ECE3400Team17/ECE3400_Team17/about_us.md

[To Home Page](./index.md)

# Get to Know Us

## Mira A. Bhut 
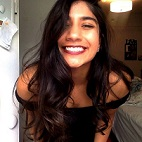
[picture p74: images/ourPics/mira.jpg]

### Contact: 
mab586@cornell.edu
### Background:
Hi, I'm Mira, a junior ECE. My interests in ECE are in electronics and embedded systems. At cornell I'm involved in Cornell Mars Rover, the fitness centers and recreational sports officiating, and tradition. I enjoy hiking and cycling and love pottery. I love reading about technology and would happily take any cool links to articles or videos you have!

## Yijia Chen 
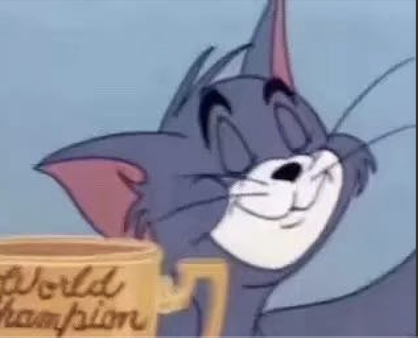
[picture p75: images/ourPics/yijia.jpg]

### Contact:
yc2366@cornell.edu
### Background:
I am a junior in ECE, from China.  I am interested in playing all kinds of instruments, taking a walk whenever I'm free, and reading whatever is interesting. I am Right now, making a robot with 4 brilliant buddies.

## Yirong Alan Cheng
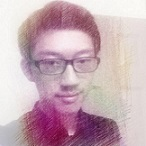
[picture p76: images/ourPics/alan.jpg]
 
### Contact:
yc2353@cornell.edu
### Background:
I am a junior in ECE. I just transferred here from UIUC in Illinois. I am the member of the IEEE-HKN (an ECE honor society). My main interests are signal processing and multimedia. I used to play badminton and swim, but now become much more indoor-orientated. I love reading books about philosophy and history on the free time, and I am also a member of the drama club.

## Thinesiya Krishnthasan

### Contact:
tk455@cornll.edu
### Background:
I'm a senior in ECE from New York City. I'm part of Cornell's Cube Satillite Team named OAAN (will be renamed VERONA soon). I enjoy working with radios, which is my independet research project here at Cornell. During my free time I love to draw, paint, and dance.

## Stephanie Lin
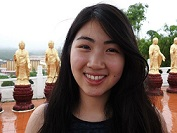
[picture p77: images/ourPics/stephanie.jpg]

### Contact:
scl97@cornell.edu
### Background:
A junior in ECE with a business minor. Hometown is the Windy City of Chicago. Likes to draw, learn languages, and drink bubble tea. Currently part of the Cornell Badminton Club with three State championship medals and will challenge anyone who dares, even a robot.

## Peter Slater
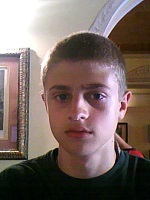
[picture p78: images/ourPics/peter.jpg]

### Contact:
pas324@cornell.edu
### Background:

[To Home Page](./index.md)
