ECE3400Team17/ECE3400_Team17/images/20170916_174542.jpg

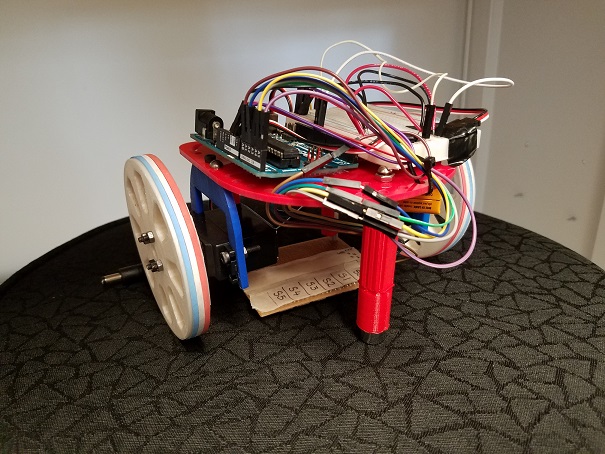
images/20170916_174542.jpg
