ECE3400Team17/ECE3400_Team17/images/frenchPolice.PNG

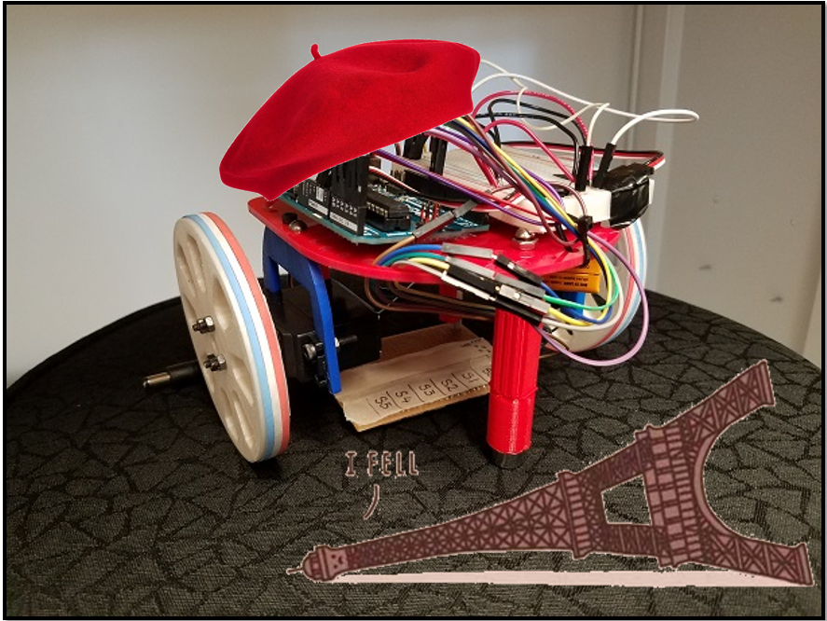
images/frenchPolice.PNG
