ECE3400Team17/ECE3400_Team17/images/Lab1/pot_LED.jpg

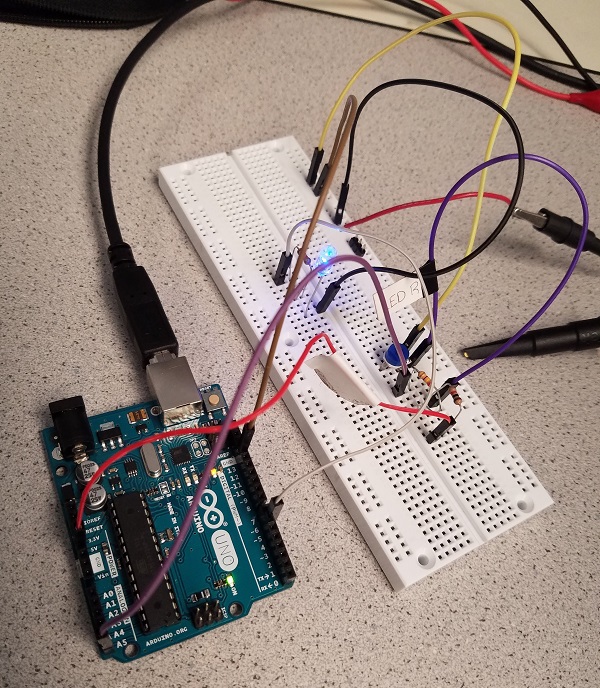
images/Lab1/pot_LED.jpg
