ECE3400Team17/ECE3400_Team17/images/Lab2/acoustics/highpass_amp_Plot.PNG

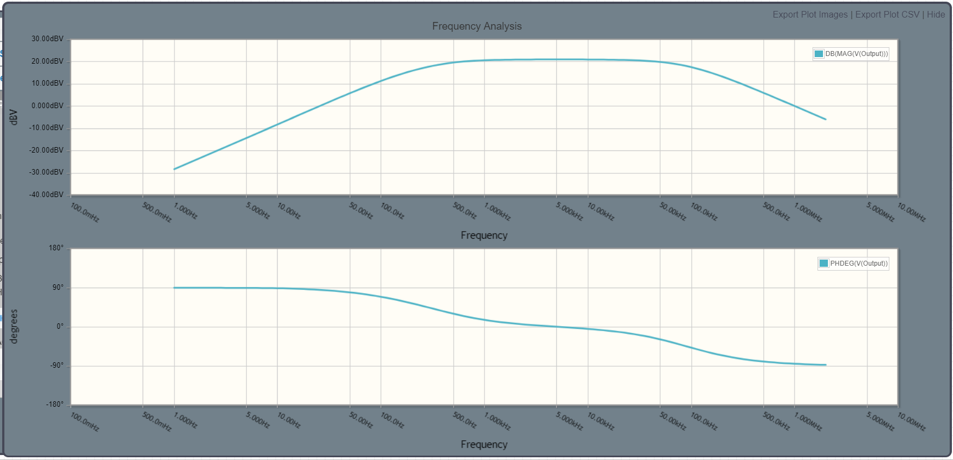
images/Lab2/acoustics/highpass_amp_Plot.PNG
