ECE3400Team17/ECE3400_Team17/images/Lab2/acoustics/LED660hz.PNG

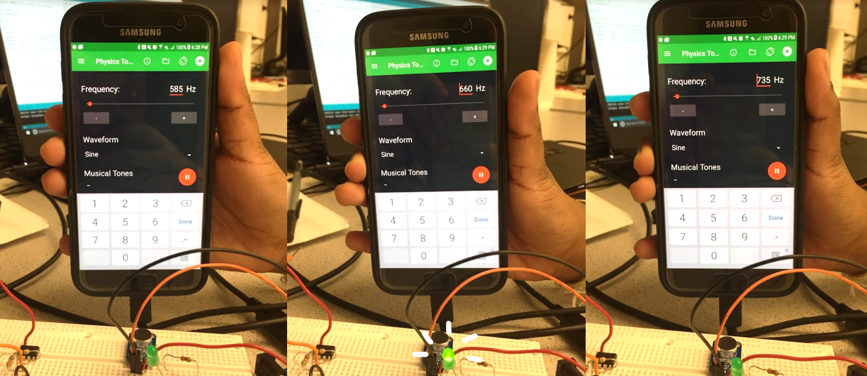
images/Lab2/acoustics/LED660hz.PNG
