ECE3400Team17/ECE3400_Team17/images/Lab2/acoustics/LowPassBodePlot.PNG

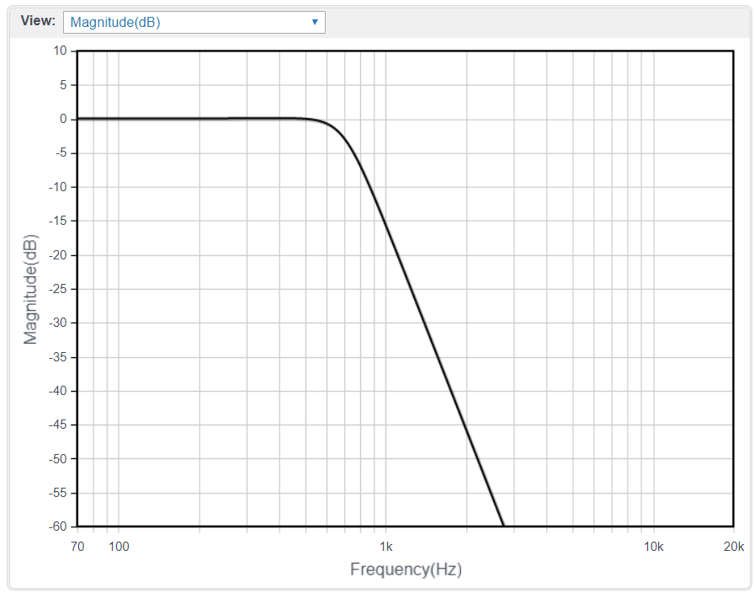
images/Lab2/acoustics/LowPassBodePlot.PNG
