ECE3400Team17/ECE3400_Team17/images/Lab2/optics/2.jpg

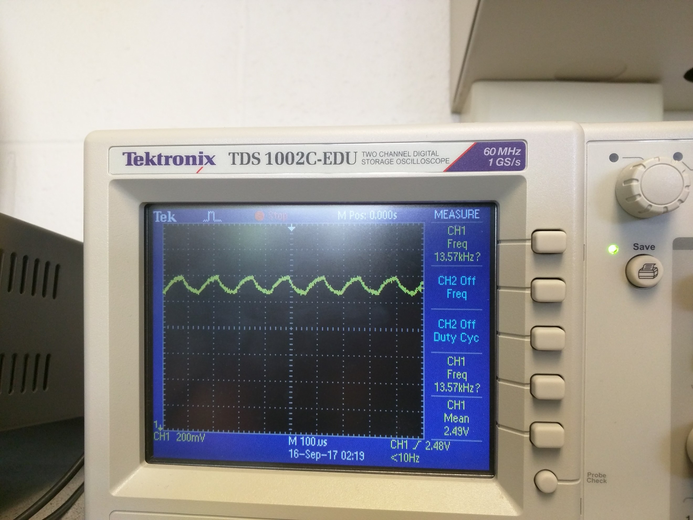
images/Lab2/optics/2.jpg
