ECE3400Team17/ECE3400_Team17/images/Lab3/FPGA_Acoustic/dacSchematic.jpg

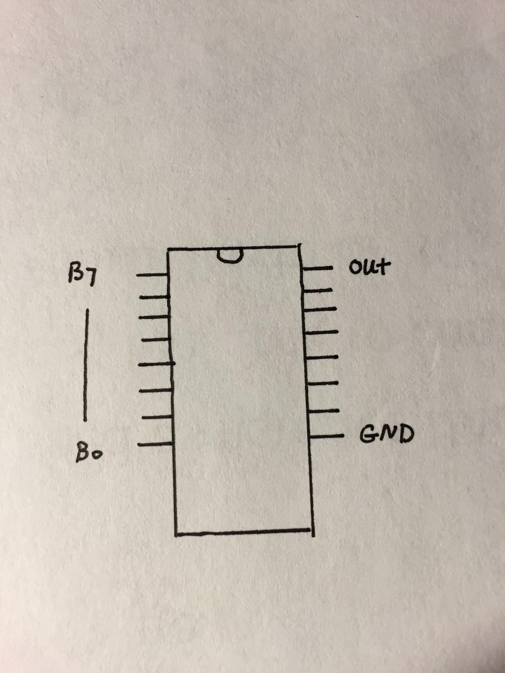
images/Lab3/FPGA_Acoustic/dacSchematic.jpg
