ECE3400Team17/ECE3400_Team17/images/Lab3/FPGA_Acoustic/squareWave.png

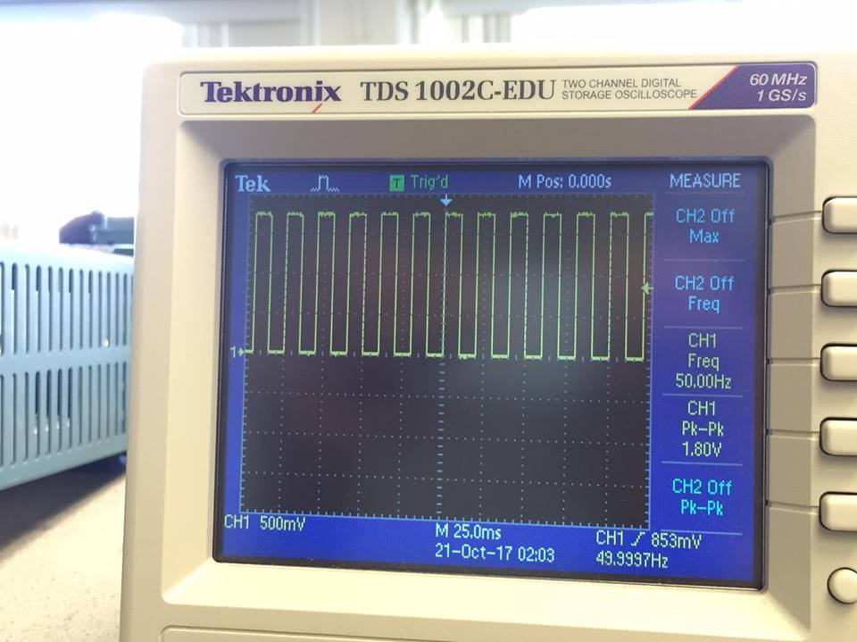
images/Lab3/FPGA_Acoustic/squareWave.png
