ECE3400Team17/ECE3400_Team17/images/Lab3/FPGA_Acoustic/soldered_circuit.jpg

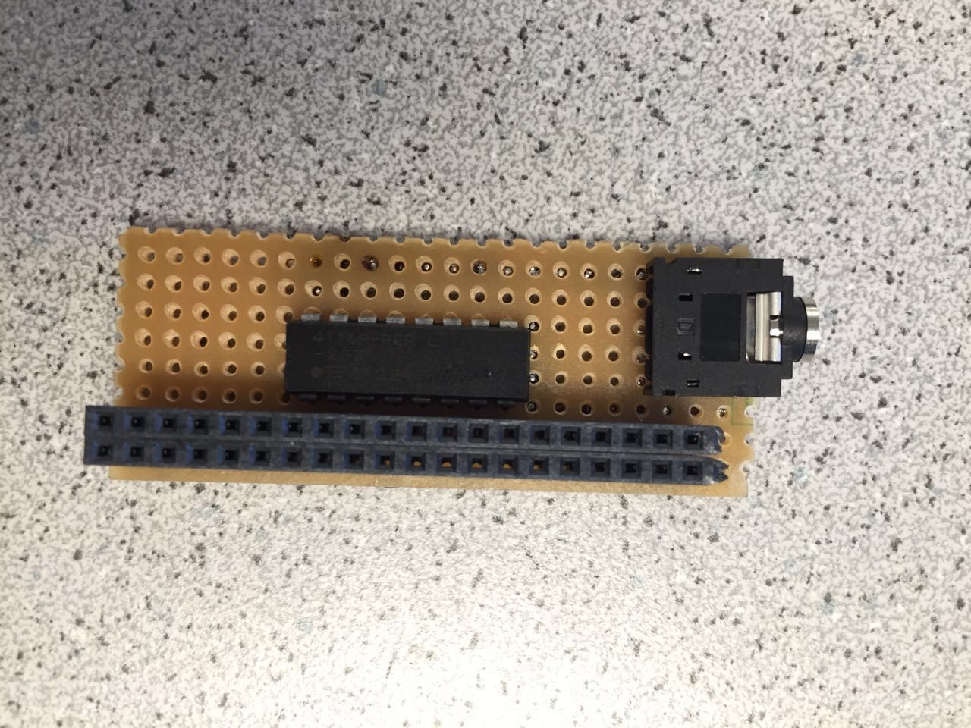
images/Lab3/FPGA_Acoustic/soldered_circuit.jpg
