ECE3400Team17/ECE3400_Team17/Code/Extra/DCmotorTest/DC_Motor_Interface.PNG

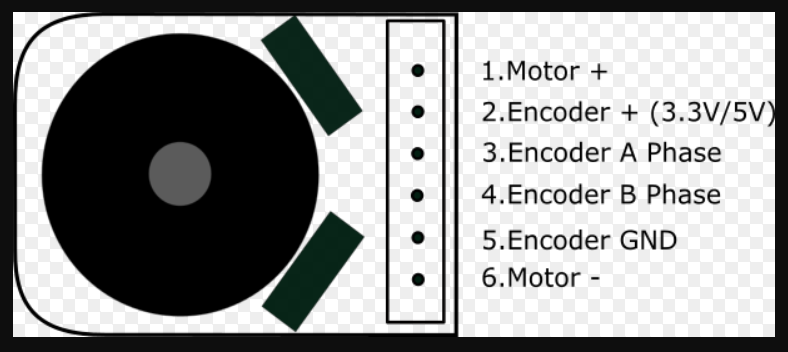
Code/Extra/DCmotorTest/DC_Motor_Interface.PNG
