ECE3400Team17/ECE3400_Team17/Code/Milestone4/Lab3_template-20171201T001724Z-001/Lab3_template/Lab3_template/TILE_DECODE.v

`define X_SIZE 10'd32
`define Y_SIZE 10'd38
`define X_OFFSET 10'd50
`define Y_OFFSET 10'd50

module TILE_DECODE (input [9:0] X, input [9:0] Y, input [167:0] MAP, input CLK, output reg [9:0] XOFF, output reg [9:0] YOFF, output reg [7:0] CELL, output reg [7:0] RBT);
	wire [4:0] rpos;
	wire [2:0] roth;
	assign rpos = MAP[164:160];
	assign roth = MAP[167:165];
	
	always @ (posedge CLK)
	begin
// row
		if(X >= (`X_SIZE*10'd0 + `X_OFFSET) && X < (`X_SIZE*(10'd0+10'd1) + `X_OFFSET) && Y >= (`Y_SIZE*10'd0 + `Y_OFFSET) && Y < (`Y_SIZE*(10'd0+10'd1) + `Y_OFFSET))
		begin 
			XOFF <= (`X_SIZE*10'd0 + `X_OFFSET);
			YOFF <= (`Y_SIZE*10'd0 + `Y_OFFSET);
			CELL <= MAP[7:0];
			if(rpos == 5'b00000)
				RBT <= {roth,5'b11111};
			else
				RBT <= {roth,5'b00000};
				
		end
		
		else if(X >= (`X_SIZE*10'd1 + `X_OFFSET) && X < (`X_SIZE*(10'd1+10'd1) + `X_OFFSET) && Y >= (`Y_SIZE*10'd0 + `Y_OFFSET) && Y < (`Y_SIZE*(10'd0+10'd1) + `Y_OFFSET))
		begin 
			XOFF <= (`X_SIZE*10'd1 + `X_OFFSET);
			YOFF <= (`Y_SIZE*10'd0 + `Y_OFFSET);
			CELL <= MAP[15:8];
			if(rpos == 5'b00001)
				RBT <= {roth,5'b11111};
			else
				RBT <= {roth,5'b00000};
		end
		
		else if(X >= (`X_SIZE*10'd2 + `X_OFFSET) && X < (`X_SIZE*(10'd2+10'd1) + `X_OFFSET) && Y >= (`Y_SIZE*10'd0 + `Y_OFFSET) && Y < (`Y_SIZE*(10'd0+10'd1) + `Y_OFFSET))
		begin 
			XOFF <= (`X_SIZE*10'd2 + `X_OFFSET);
			YOFF <= (`Y_SIZE*10'd0 + `Y_OFFSET);
			CELL <= MAP[23:16];
			if(rpos == 5'b00010)
				RBT <= {roth,5'b11111};
			else
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
			CELL <= MAP[159:152];
			if(rpos == 5'b10011)
				RBT <= {roth,5'b11111};
			else
				RBT <= {roth,5'b00000};
		end
		
		else
		begin
			XOFF <= 10'b1111111111;
			YOFF <= 10'b1111111111;
			CELL <= 8'b00000000;
			RBT <= 8'b00000000;
		end
	end
	
endmodule
