ECE3400Team17/ECE3400_Team17/Code/Milestone3/L298_Arduino_Tutorial/L298_Arduino_Tutorial.ino

//L293D
//Motor A
const int motorPin1  = 9;  // Pin 14 of L293
const int motorPin2  = 10;  // Pin 10 of L293
//Motor B
const int motorPin3  = 6; // Pin  7 of L293
const int motorPin4  = 5;  // Pin  2 of L293

//This will run only one time.
void setup(){
 
    //Set pins as outputs
    pinMode(motorPin1, OUTPUT);
    pinMode(motorPin2, OUTPUT);
    pinMode(motorPin3, OUTPUT); 
    pinMode(motorPin4, OUTPUT);
    
    //Motor Control - Motor A: motorPin1,motorpin2 & Motor B: motorpin3,motorpin4

    //This code  will turn Motor A clockwise for 2 sec.
    analogWrite(motorPin1, 180);
    analogWrite(motorPin2, 0);
    analogWrite(motorPin3, 180);
    analogWrite(motorPin4, 0);
    delay(5000); 
    //This code will turn Motor A counter-clockwise for 2 sec.
    analogWrite(motorPin1, 0);
    analogWrite(motorPin2, 180);
    analogWrite(motorPin3, 0);
    analogWrite(motorPin4, 180);
    delay(5000);
    
    //This code will turn Motor B clockwise for 2 sec.
    analogWrite(motorPin1, 0);
    analogWrite(motorPin2, 180);
    analogWrite(motorPin3, 180);
    analogWrite(motorPin4, 0);
    delay(1000); 
    //This code will turn Motor B counter-clockwise for 2 sec.
    analogWrite(motorPin1, 180);
    analogWrite(motorPin2, 0);
    analogWrite(motorPin3, 0);
    analogWrite(motorPin4, 180);
    delay(1000);    
    
    //And this code will stop motors
    analogWrite(motorPin1, 0);
    analogWrite(motorPin2, 0);
    analogWrite(motorPin3, 0);
    analogWrite(motorPin4, 0);
  
}


void loop(){
  

}
