ECE3400Team17/ECE3400_Team17/(commit log)

2017-10-06 added codes
    [Book1.xlsx, fftPlots.xlsx, fftPlotsSmallBin.xlsx]
2017-12-05 final 1
    [66-fft.xlsx]
